dallday/28C18-programmer/pictures/Parts used.jpg

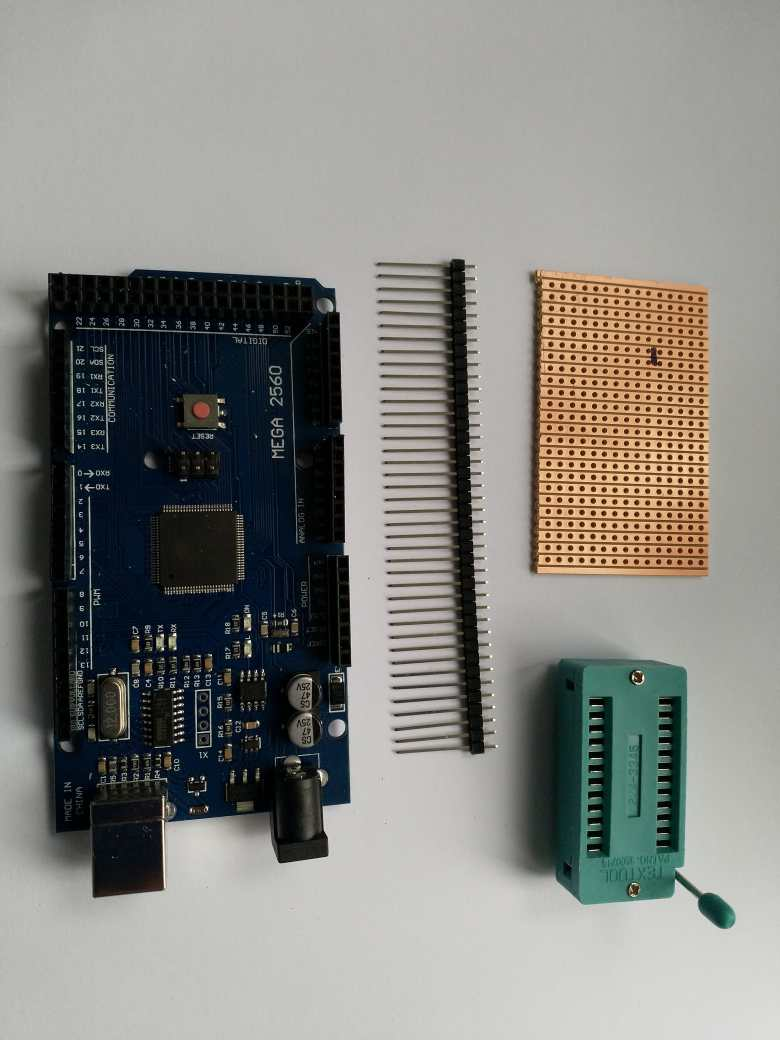
pictures/Parts used.jpg
