dallday/28C18-programmer/pictures/Soldered on the long arduino pins.jpg

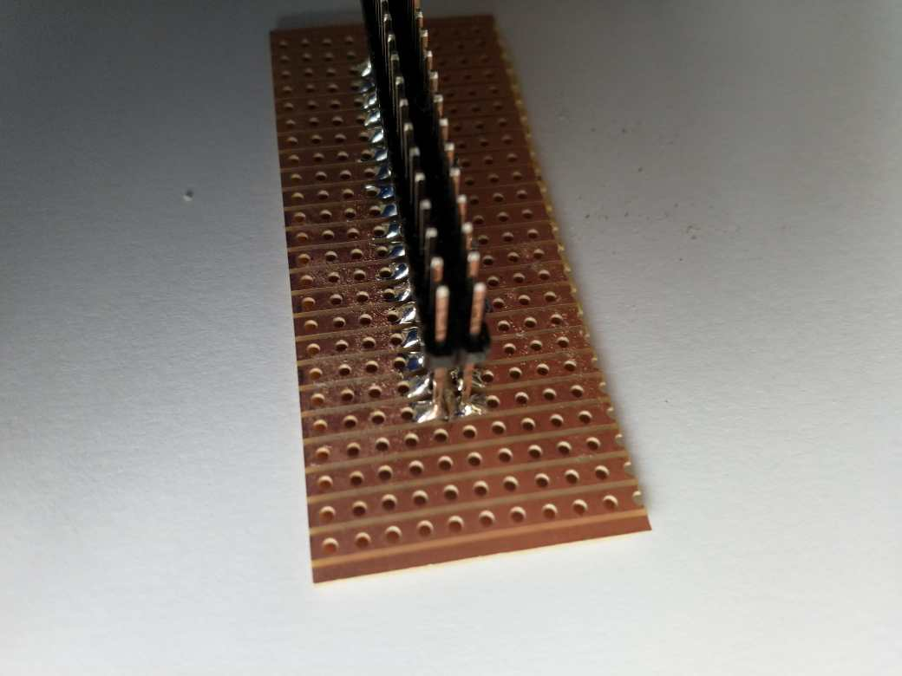
pictures/Soldered on the long arduino pins.jpg
