dallday/28C18-programmer/EPROM_2816_mega2560_Version1/documentation/readme.txt

This is where the idea came from

http://danceswithferrets.org/geekblog/?page_id=903
and
http://blog.tynemouthsoftware.co.uk/2017/12/arduino-eeprom-programmer.html

This is for the bigger 28c64 chips and uses Mega and loads of pins !!
But gives details on locking eeproms

also python style script

Chris Baird’s Python script (an alternative controller for non-Windows users). Chris classes it as something he “knocked up in a hurry” so it should be treated with care … but if you’re a Python programmer, it might be a very useful starter for you. megaprogrammer28.py (5KB)
