dallday/28C18-programmer/pictures/Added Resistors.jpg

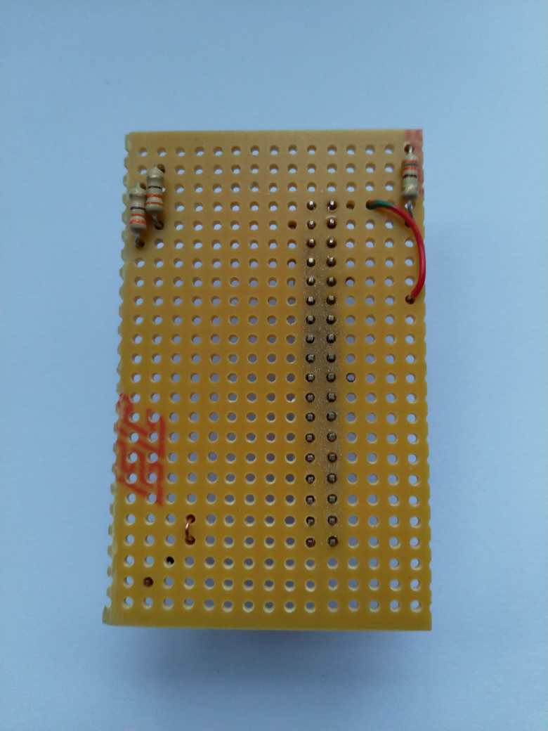
pictures/Added Resistors.jpg
