dallday/28C18-programmer/pictures/Another view of the pins.jpg

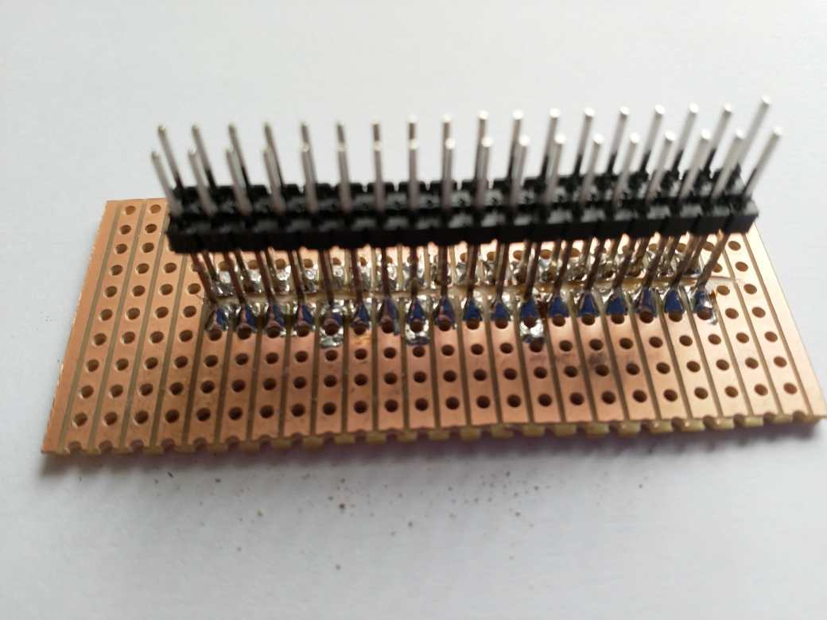
pictures/Another view of the pins.jpg
