dallday/28C18-programmer/pictures/Final board from above.jpg

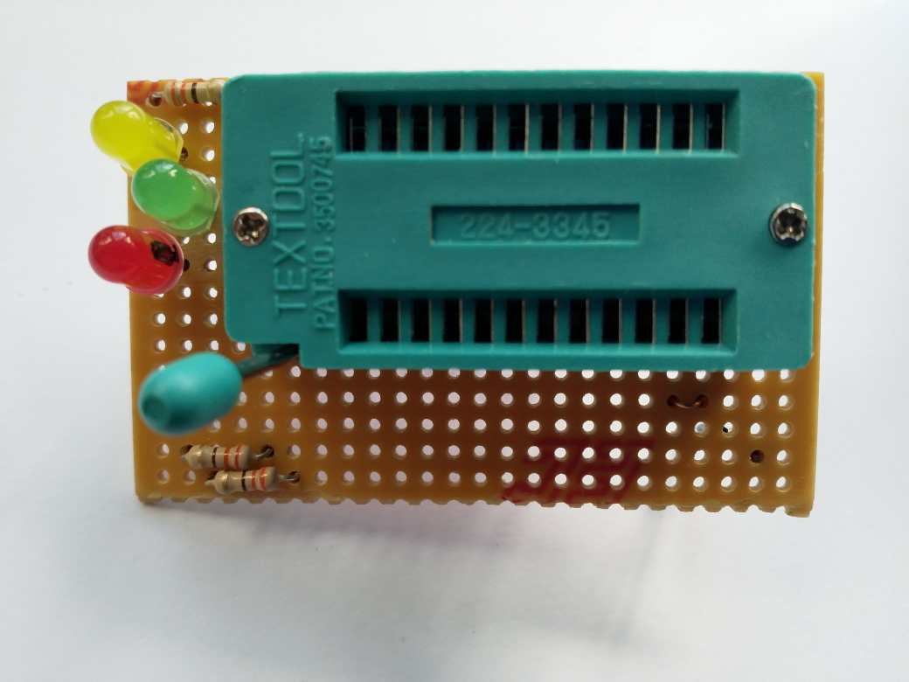
pictures/Final board from above.jpg
