dallday/28C18-programmer/pictures/FinalVersion.jpg

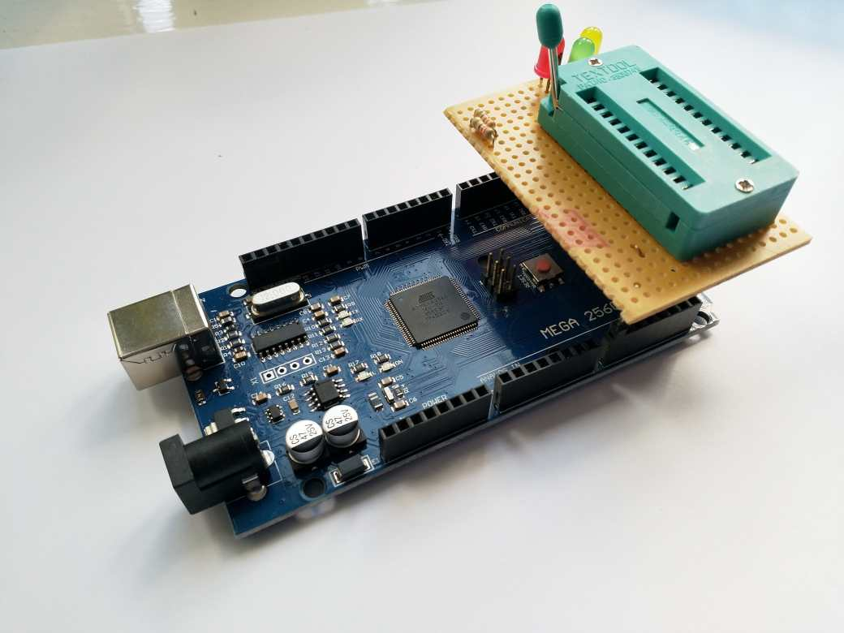
pictures/FinalVersion.jpg
