dallday/28C18-programmer/pictures/Veraboard initial cut.jpg

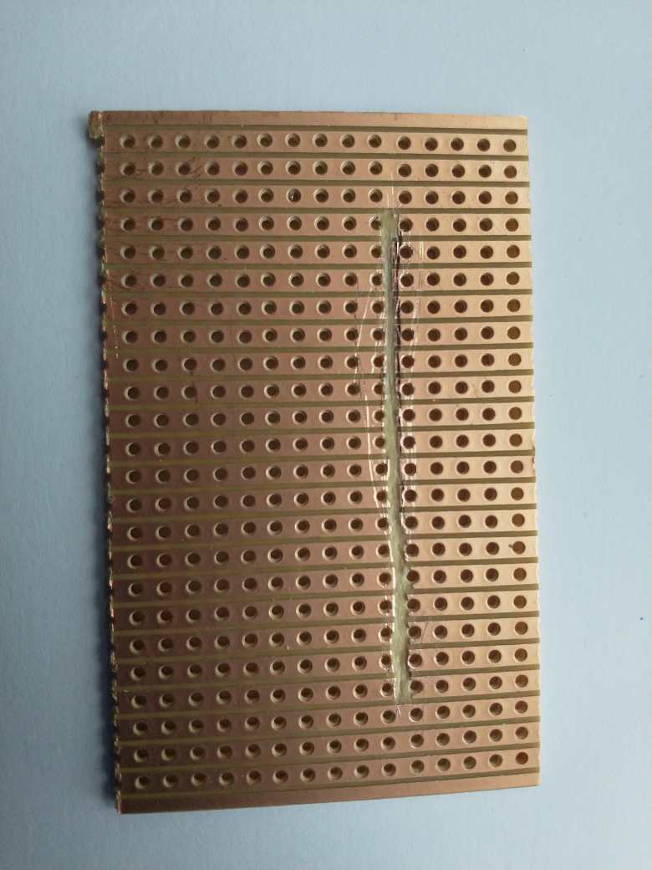
pictures/Veraboard initial cut.jpg
