dallday/28C18-programmer/pictures/View from underneath2.jpg

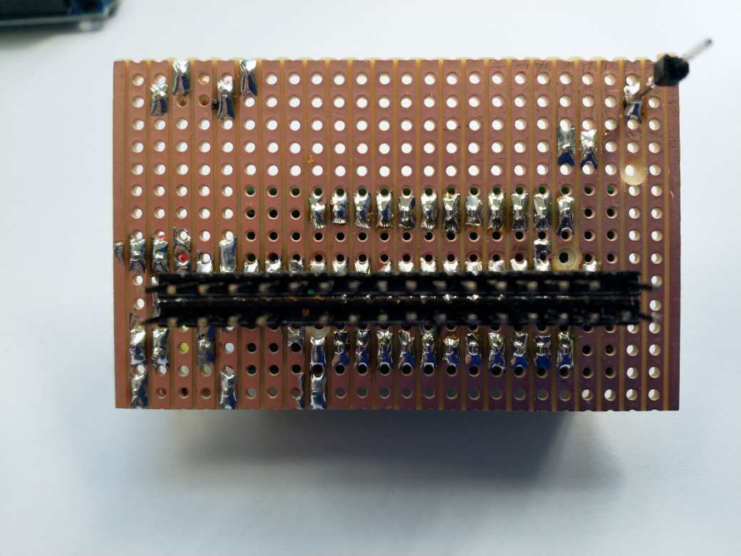
pictures/View from underneath2.jpg
