dallday/28C18-programmer/pictures/View from underneath.jpg

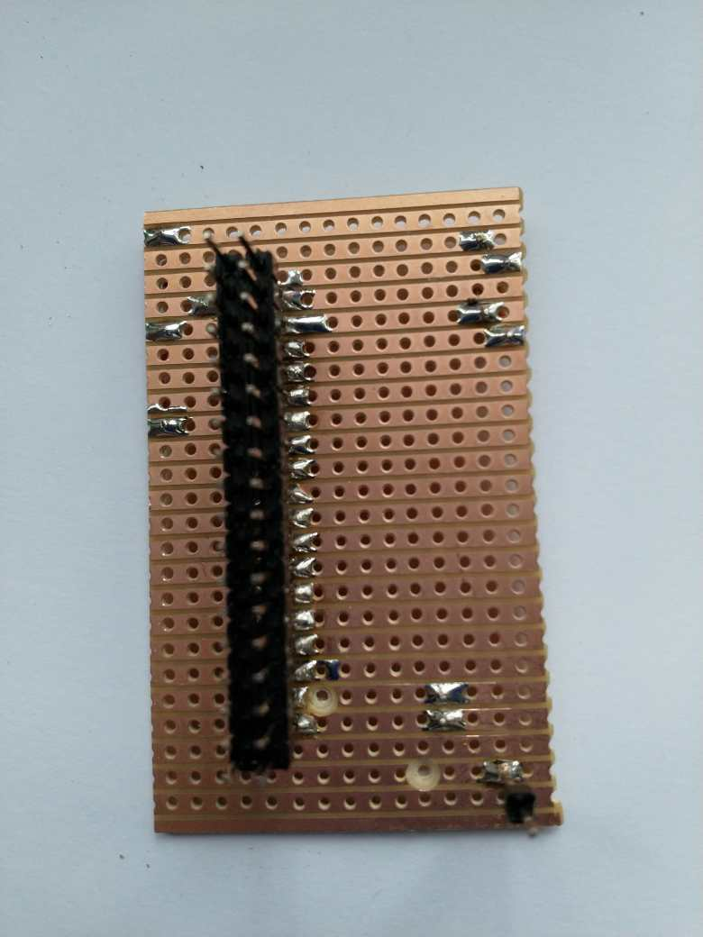
pictures/View from underneath.jpg
