dallday/28C18-programmer/pictures/just before soldering the Zif socket.jpg

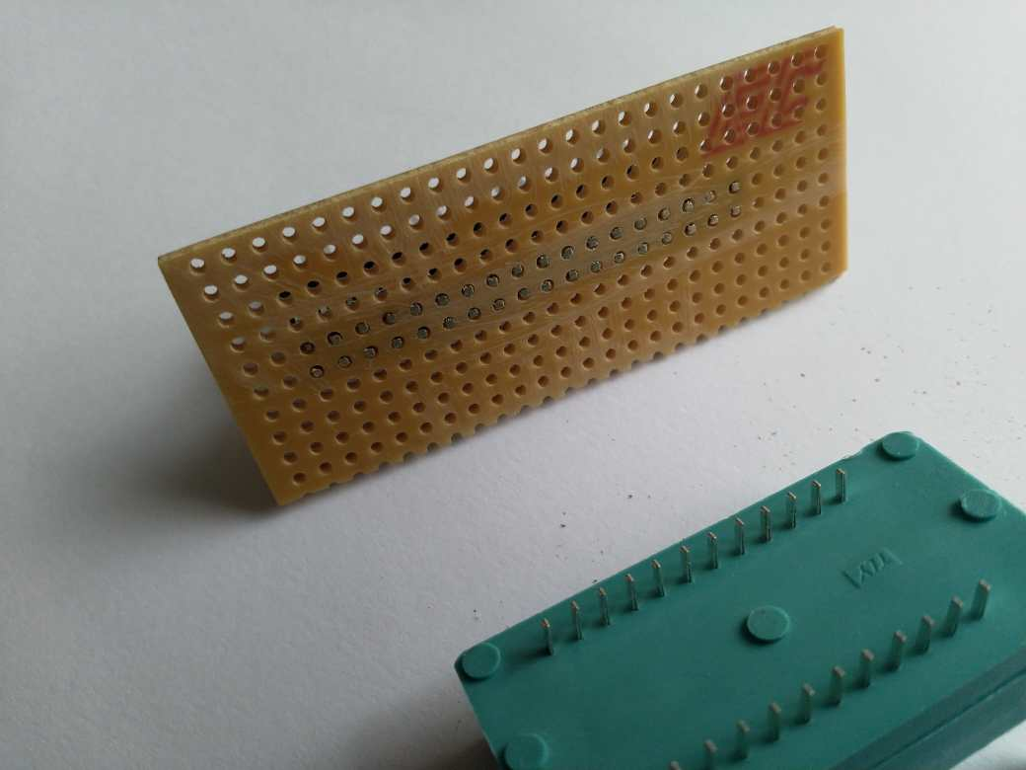
pictures/just before soldering the Zif socket.jpg
